KacperBizon/puya_tamagotchi/pcb/README.md

* PA0 - RED DIODE
* PA1 - WHITE DIODE
* PA2 - SWCLK
* PA3 - LDR_DRIVE
* PA4 - BUTTON_1
* PA5 - BUTTON_2
* PA6 - BUTTON_3
* PA7 - BUTTON_4

* PB0 - TIM1_CH2 - BUZZER
* PB1 - ADC_IN0 - LDR_OUT
* PB3 - I2C1 SDL - SSD1306
* PB4 - I2C1 SDA - SSD1306
* PB6 - SWDIO
* PB7 - NC

* PC1 - NC

* TP1 - GND
* TP2 - VCC
* TP3 - VBUS
* TP4 - +BATT
* TP5 - I2C.SCL
* TP6 - I2C.SDA
