KacperBizon/puya_tamagotchi/pcb/puya_tamagotchi.kicad_pcb

## KiCad design pcb/puya_tamagotchi.kicad_pcb (2026-10-30)

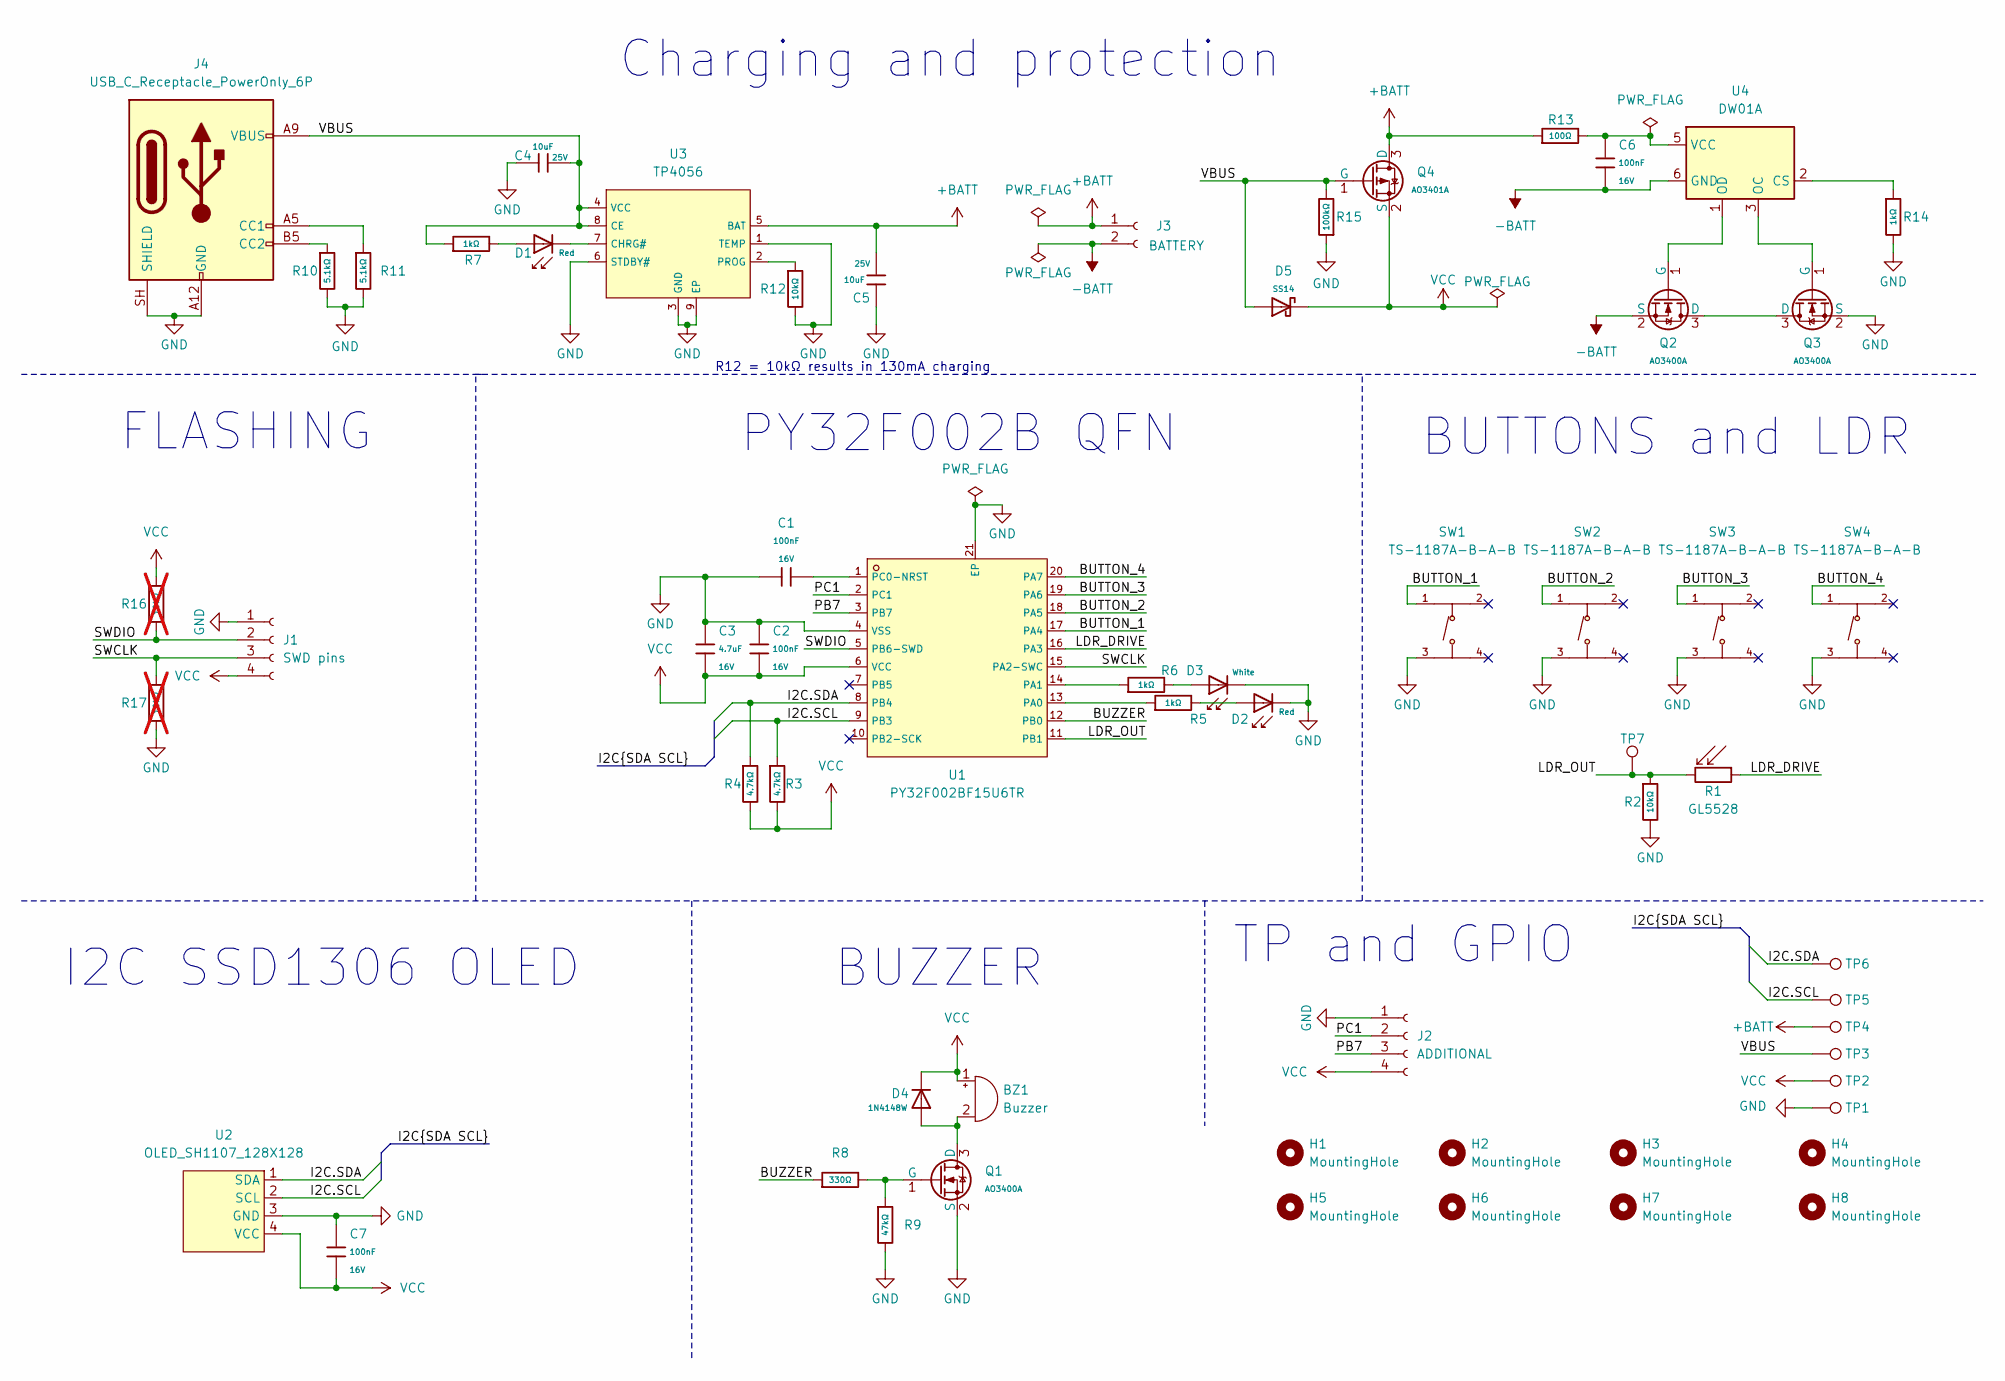
[picture p1: schematic puya_tamagotchi.kicad_sch]

Parts:
BZ1: Buzzer; Buzzer_12x9.5RM7.6
C1, C2, C6, C7: 100nF; C_0402; Voltage Rated 16V; Tolerance ±10%; Part CL05B104KO5NNNC; LCSC C1525
C3: 4.7uF; C_0603; Voltage Rated 16V; Tolerance ±10%; Part CL10A475KO8NNNC; LCSC C19666
C4, C5: 10uF; C_0603; Voltage Rated 25V; Tolerance ±20%; Part CL10A106MA8NRNC; LCSC C96446
D1, D2: Red; D_0603; Part KT-0603R; LCSC C2286
D3: White; D_0603; Part KT-0603W; LCSC C2290
D4: 1N4148W; D_SOD-123; Forward Voltage (Vf@If) 1V@50mA; Reverse Voltage (Vr) 75V; Part 1N4148W; LCSC C81598
D5: SS14; D_SMA; Forward Voltage (Vf@If) 550mV@1A; Reverse Voltage (Vr) 40V; Part SS14; LCSC C2480
H1, H2, H3, H4, H5, H6, H7, H8: MountingHole; MountingHole_2.2mm_M2
J1: SWD pins; PinSocket_1x04_P2.54mm_Vertical
J2: ADDITIONAL; PinSocket_1x04_P2.54mm_Vertical
J3: BATTERY; JST_EH_B2B-EH-A_1x02_P2.50mm_Vertical
J4: USB_C_Receptacle_PowerOnly_6P; USB_C_Receptacle_HRO_TYPE-C-31-M-17
Q1, Q2, Q3: AO3400A; Q_SOT-23; Part AO3400A; LCSC C20917
Q4: AO3401A; Q_SOT-23; Part AO3401A; LCSC C15127
R1: GL5528; R_LDR_5.1x4.3mm_P3.4mm_Vertical
R2, R12: 10kΩ; R_0402; Overload Voltage (Max) 50V; Tolerance ±1%; Part 0402WGF1002TCE; LCSC C25744
R3, R4: 4.7kΩ; R_0402; Overload Voltage (Max) 50V; Tolerance ±1%; Part 0402WGF4701TCE; LCSC C25900
R5, R6, R7, R14: 1kΩ; R_0402; Overload Voltage (Max) 50V; Tolerance ±1%; Part 0402WGF1001TCE; LCSC C11702
R8: 330Ω; R_0402; Overload Voltage (Max) 50V; Tolerance ±1%; Part 0402WGF3300TCE; LCSC C25104
R9: 47kΩ; R_0402; Overload Voltage (Max) 50V; Tolerance ±1%; Part 0402WGF4702TCE; LCSC C25792
R10, R11: 5.1kΩ; R_0402; Overload Voltage (Max) 50V; Tolerance ±1%; Part 0402WGF5101TCE; LCSC C25905
R13: 100Ω; R_0402; Overload Voltage (Max) 50V; Tolerance ±1%; Part 0402WGF1000TCE; LCSC C25076
R15: 100kΩ; R_0402; Overload Voltage (Max) 50V; Tolerance ±1%; Part 0402WGF1003TCE; LCSC C25741
R16, R17: 10kΩ; R_0402; Overload Voltage (Max) 50V; Tolerance ±1%; Part 0402WGF1002TCE; LCSC C25744; not fitted
SW1, SW2, SW3, SW4: TS-1187A-B-A-B; SW-SMD_4P-L5.1-W5.1-P3.70-LS6.5-TL_H1.5; LCSC C318884
TP1, TP2, TP3, TP4, TP5, TP6, TP7: TestPoint; TestPoint_Pad_D1.0mm
U1: PY32F002BF15U6TR; QFN-20_L3.0-W3.0-P0.40-TL-EP1.7; LCSC C7469099
U2: OLED_SH1107_128X128; SH1107_128x128_OLED
U3: TP4056; ESOP-8_L4.9-W3.9-P1.27-LS6.0-BL-EP; Part TP4056-42-ESOP8; LCSC C16581
U4: DW01A; SOT-23-6

Connections:
+BATT: C5.2, J3.1, Q4.3 (D), R13.1, TP4.1 (1_1), U3.5 (BAT)
-BATT: C6.2, J3.2, Q2.2 (S), U4.6 (GND)
/BUTTON_1: SW1.1 (A), U1.17 (PA4)
/BUTTON_2: SW2.1 (A), U1.18 (PA5)
/BUTTON_3: SW3.1 (A), U1.19 (PA6)
/BUTTON_4: SW4.1 (A), U1.20 (PA7)
/BUZZER: R8.1, U1.12 (PB0)
/I2C.SCL: R3.1, TP5.1 (1_1), U1.9 (PB3), U2.2 (SCL)
/I2C.SDA: R4.1, TP6.1 (1_1), U1.8 (PB4), U2.1 (SDA)
/LDR_DRIVE: R1.1, U1.16 (PA3)
/LDR_OUT: R1.2, R2.1, TP7.1 (1_1), U1.11 (PB1)
/PB7: J2.3, U1.3 (PB7)
/PC1: J2.2, U1.2 (PC1)
/SWCLK: J1.3, R17.1, U1.15 (PA2-SWC)
/SWDIO: J1.2, R16.2, U1.5 (PB6-SWD)
/VBUS: C4.2, D5.2, J4.A9 (VBUS), J4.B9 (VBUS), Q4.1 (G), R7.1, R15.2, TP3.1 (1_1), U3.4 (VCC), U3.8 (CE)
GND: C1.1, C2.1, C3.1, C4.1, C5.1, C7.1, D2.1, D3.1, J1.1, J2.1, J4.A12 (GND), J4.B12 (GND), J4.SH (SHIELD), Q1.2 (S), Q3.2 (S), R2.2, R9.2, R10.2, R11.2, R12.2, R14.2, R15.1, R17.2, SW1.3 (C), SW2.3 (C), SW3.3 (C), SW4.3 (C), TP1.1 (1_1), U1.4 (VSS), U1.21 (EP), U2.3 (GND), U3.1 (TEMP), U3.3 (GND), U3.6 (STDBY#), U3.9 (EP)
unnamed: BZ1.2 (-), D4.2, Q1.3 (D)
unnamed: D1.2, R7.2
unnamed: D2.2, R5.2
unnamed: D3.2, R6.2
unnamed: J4.A5 (CC1), R11.1
unnamed: J4.B5 (CC2), R10.1
unnamed: Q1.1 (G), R8.2, R9.1
unnamed: Q2.3 (D), Q3.3 (D)
unnamed: Q2.1 (G), U4.1 (OD)
unnamed: Q3.1 (G), U4.3 (OC)
unnamed: R5.1, U1.13 (PA0)
unnamed: R6.1, U1.14 (PA1)
unnamed: C1.2, U1.1 (PC0-NRST)
unnamed: D1.1, U3.7 (CHRG#)
unnamed: R12.1, U3.2 (PROG)
unnamed: R14.1, U4.2 (CS)
unnamed: C6.1, R13.2, U4.5 (VCC)
VCC: BZ1.1 (+), C2.2, C3.2, C7.2, D4.1, D5.1, J1.4, J2.4, Q4.2 (S), R3.2, R4.2, R16.1, TP2.1 (1_1), U1.6 (VCC), U2.4 (VCC)

Notes on the sheet:
Charging and protection
R12 = 10kΩ results in 130mA charging
BUTTONS and LDR
BUZZER
PY32F002B QFN
FLASHING
TP and GPIO
I2C SSD1306 OLED

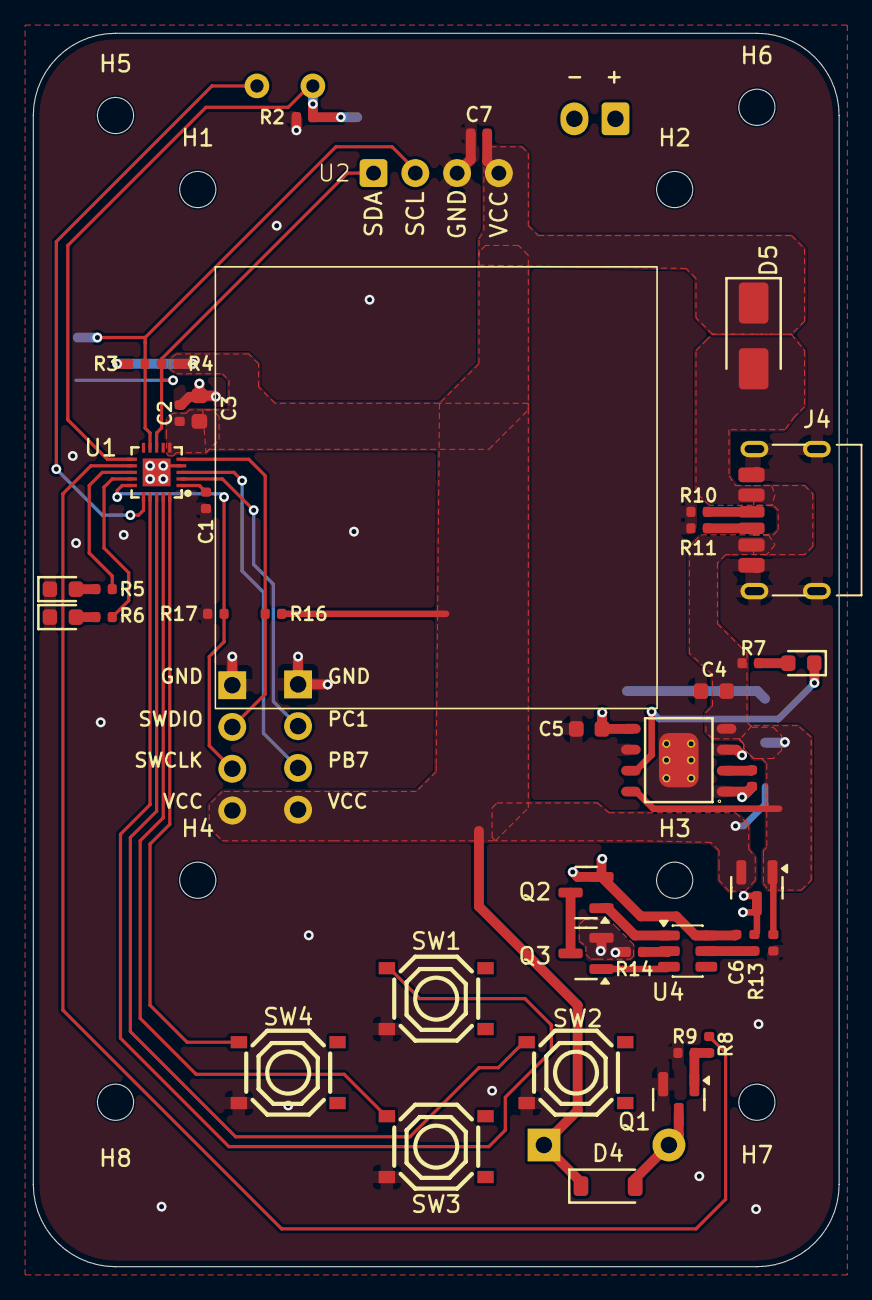
[picture p2: board puya_tamagotchi.kicad_pcb from above]

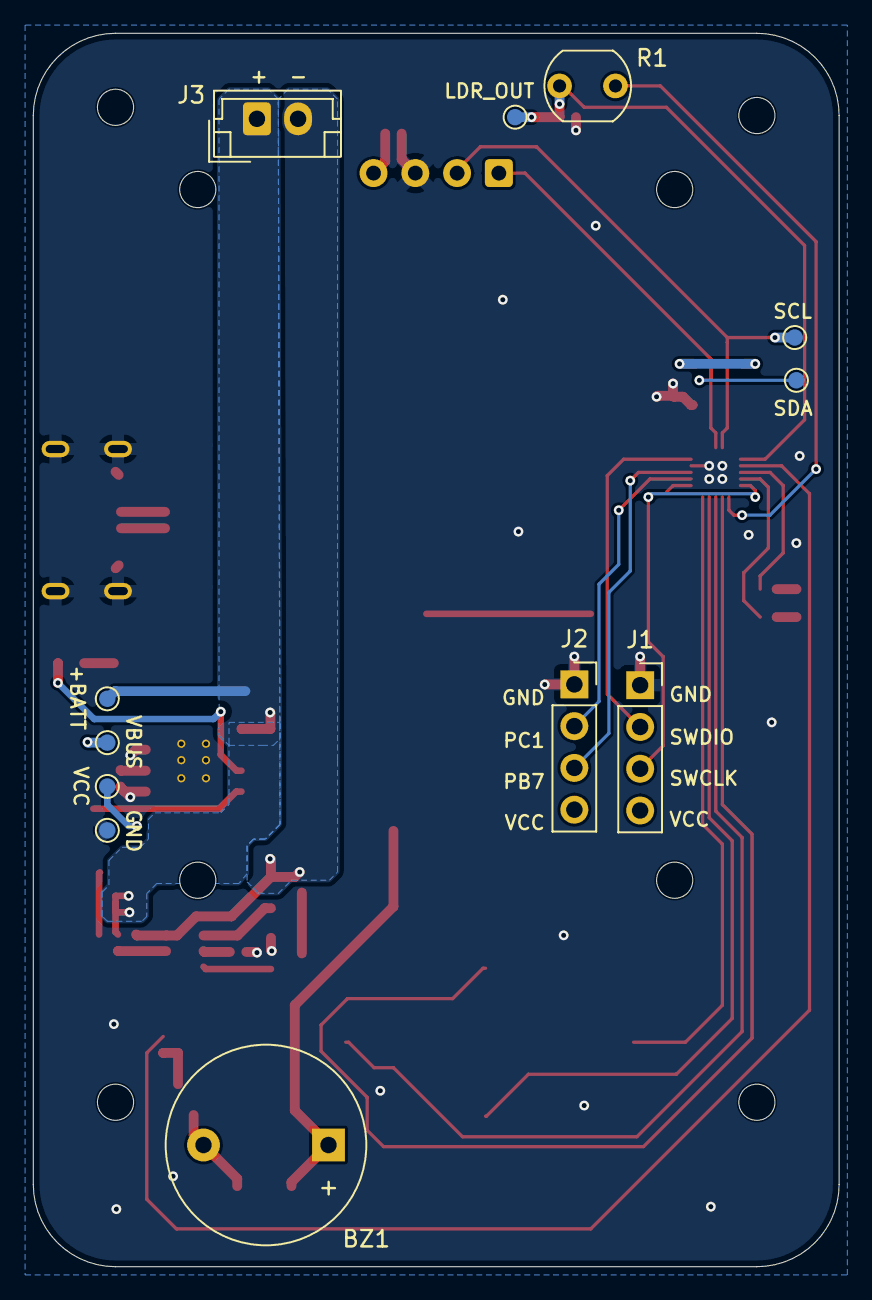
[picture p3: board puya_tamagotchi.kicad_pcb from below]

Board: 2 copper layers, 49.0 x 75.0 mm, 61 parts (12 on the bottom side), 35 nets.
