KacperBizon/puya_tamagotchi/(commit log)

2026-08-31 Add empty project
    [puya_tamagotchi.kicad_pcb, puya_tamagotchi.kicad_sch]
2026-09-02 Add SSD1306 I2C module
2026-09-02 Add PUYA PY32F002B
    [puya_tamagotchi.kicad_sch]
2026-09-03 Add Peripherals
    [puya_tamagotchi.kicad_sch]
2026-09-04 Add TPs and LEDs
    [puya_tamagotchi.kicad_sch]
2026-09-04 Add Buzzer
    [puya_tamagotchi.kicad_sch]
2026-09-05 Add charging and protection, clean schematic
    [puya_tamagotchi.kicad_sch]
2026-09-06 Clean schematic, add load sharing
    [puya_tamagotchi.kicad_sch]
2026-09-10 Add edgecuts
    [puya_tamagotchi.kicad_pcb]
2026-10-11 Add SSH1107 OLED to schematic
    [puya_tamagotchi.kicad_sch]
2026-10-14 Clean schematic
    [puya_tamagotchi.kicad_sch]
2026-10-20 Outline component placement
    [puya_tamagotchi.kicad_pcb]
2026-10-20 Add mounting holes
    [puya_tamagotchi.kicad_sch]
2026-10-20 Align components, add edgecuts
    [puya_tamagotchi.kicad_pcb]
2026-10-25 Wire signals
    [puya_tamagotchi.kicad_pcb]
2026-10-25 Wire whole board
    [puya_tamagotchi.kicad_pcb]
2026-10-27 Add OLED decoupling, SWD resistors
    [puya_tamagotchi.kicad_sch]
2026-10-27 Update routing
    [puya_tamagotchi.kicad_pcb]
2026-10-30 Add battery and usb silkscreen
    [puya_tamagotchi.kicad_pcb]
